EE-crisrmh/VIGIL-Systems/hardware/images/rip_board.jpg

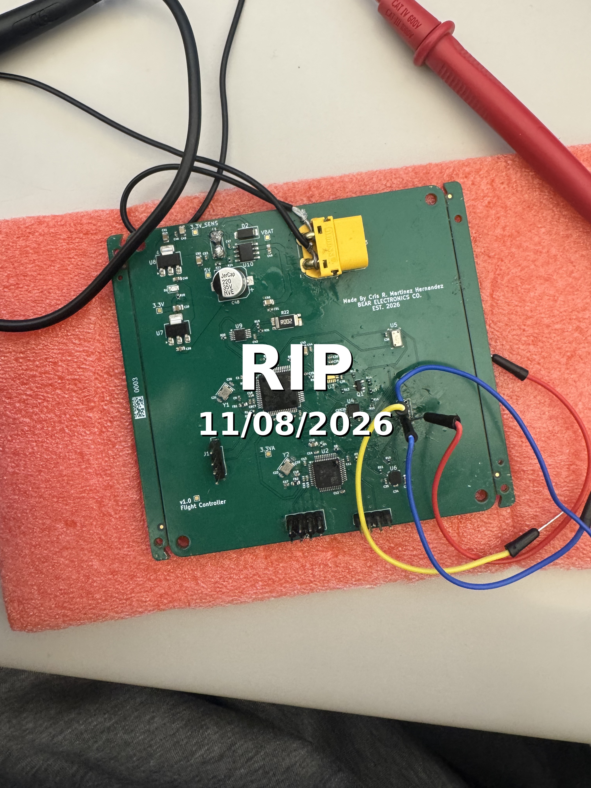
hardware/images/rip_board.jpg
