EE-crisrmh/VIGIL-Systems/software/README.md

# software

companion computer code for the jetson nano: ros2 nodes, mavlink communication with the flight controller, patrol state machine, person detection, photo capture and alarm integration.

status: not started.
