EE-crisrmh/VIGIL-Systems/mechanical/cad/f450_frame_cross_clips_fc_holes.3mf

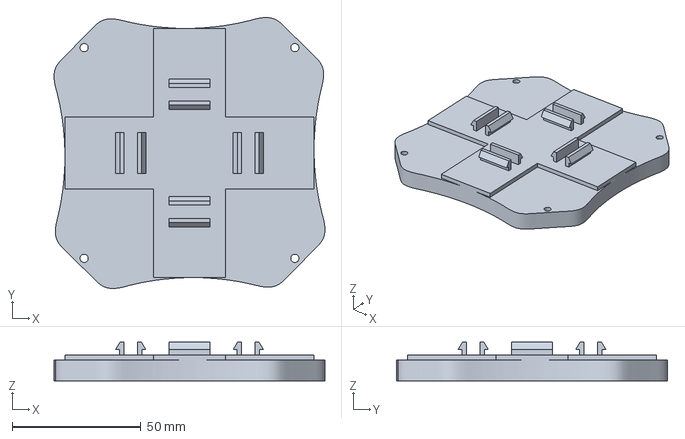
[picture p20: CAD file, 2026-11-03]
mechanical/cad/f450_frame_cross_clips_fc_holes.3mf
105.4 x 105.4 x 15.0 mm
