EE-crisrmh/VIGIL-Systems/mechanical/cad/FlightControllerv1.0.step

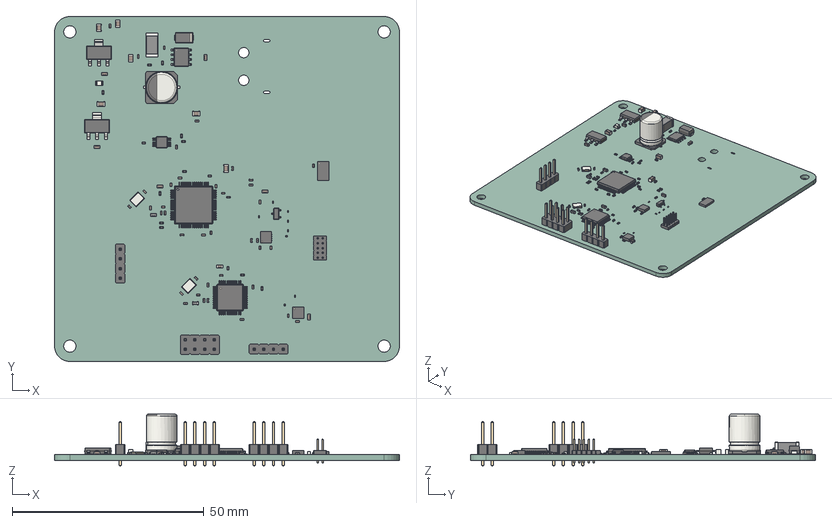
[picture p21: CAD file, 2026-11-03]
mechanical/cad/FlightControllerv1.0.step
90.0 x 90.0 x 13.5 mm
PinHeader_2x05_P1.27mm_Vertical
PinHeader_1x04_P2.54mm_Vertical x 2
R_0201_0603Metric x 8
C_0402_1005Metric x 39
C_0603_1608Metric x 7
PinHeader_2x04_P2.54mm_Vertical
LED_0805_2012Metric
HTSOP-8-1EP_3.9x4.9mm_Pitch1.27mm
L_0603_1608Metric x 2
C_0805_2012Metric x 6
R_0402_1005Metric x 15
LGA-16_3x3mm_P0.5mm x 2
VSSOP-10_3x3mm_P0.5mm
D_SMA
LQFP-48_7x7mm_P0.5mm
Crystal_SMD_3225-4Pin_3.2x2.5mm x 2
SOT-223 x 2
LQFP-64_10x10mm_P0.5mm
SOT-23
L_2512_6332Metric
CP_Elec_8x10.5
LGA-8_3x5mm_P1.25mm
FlightControllerv1.0_PCB
