EE-crisrmh/VIGIL-Systems/(list of files, cad)

Other CAD files:
mechanical/cad/.stl
