EE-crisrmh/VIGIL-Systems/hardware/kicad/FlightControllerv1.0.pdf

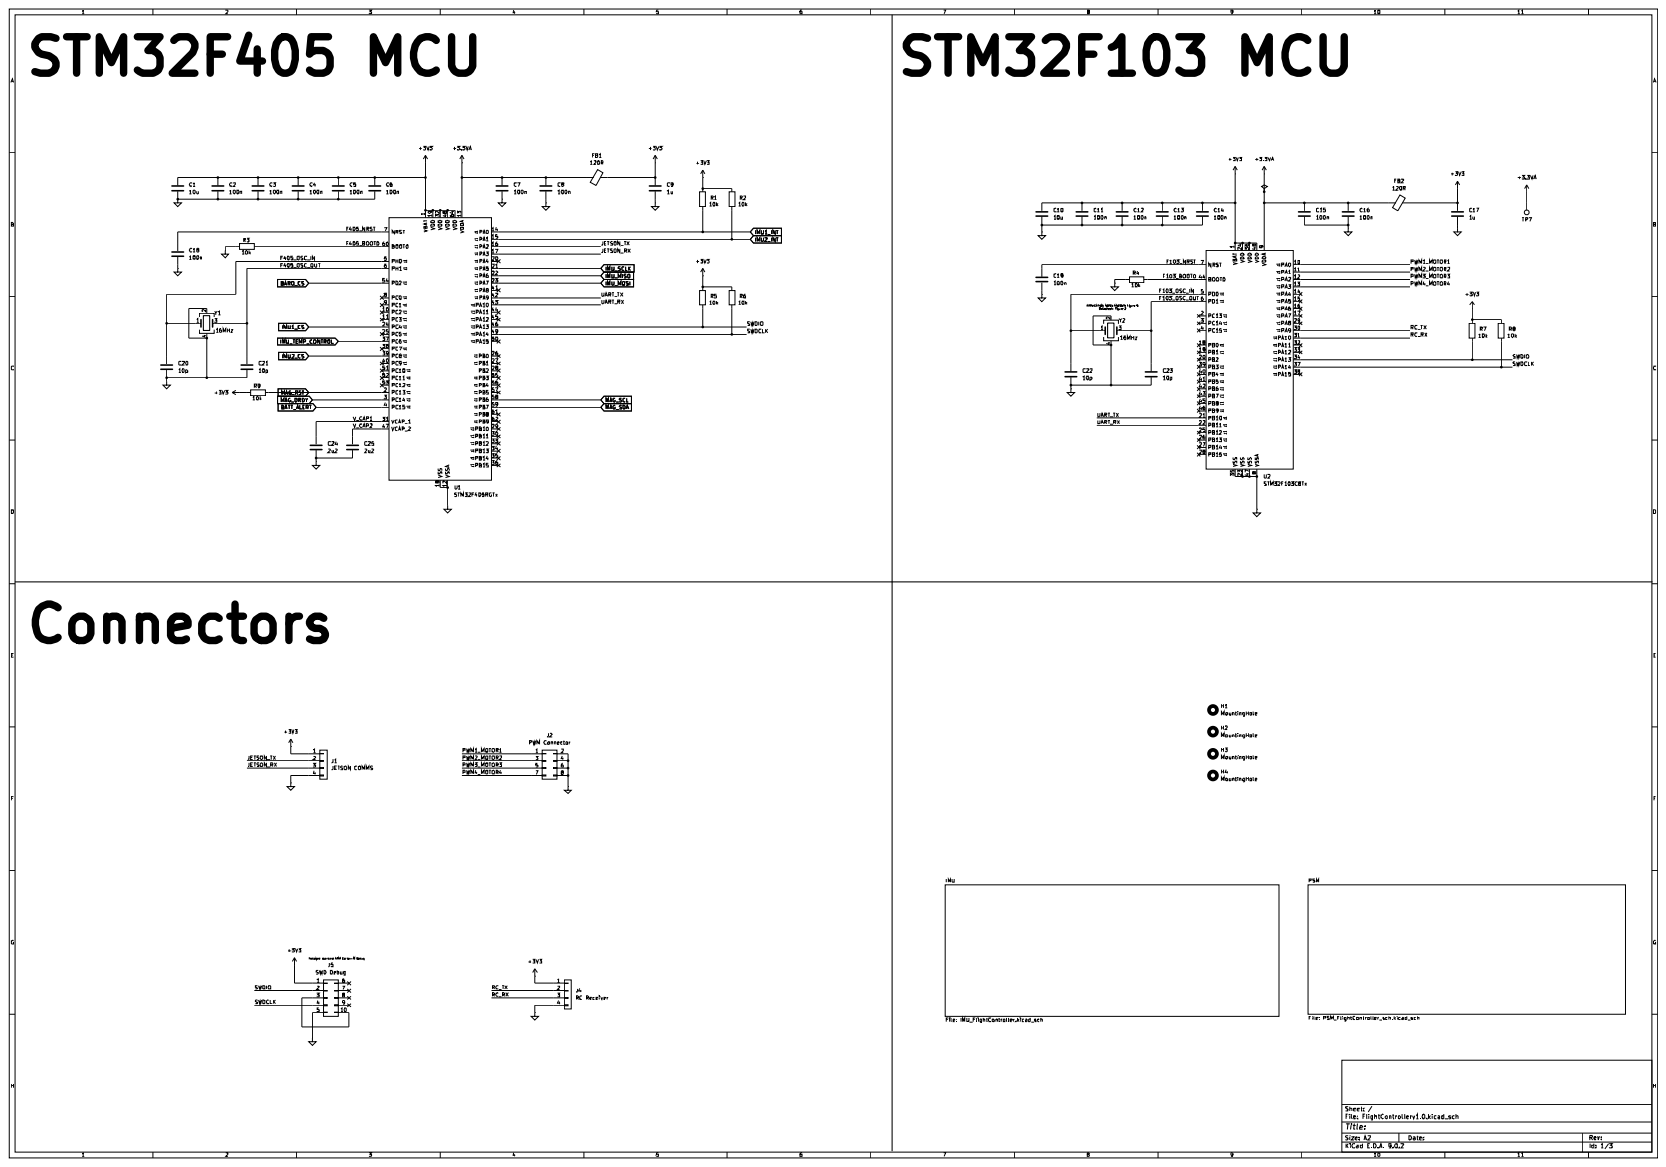
[picture p22: page 1]

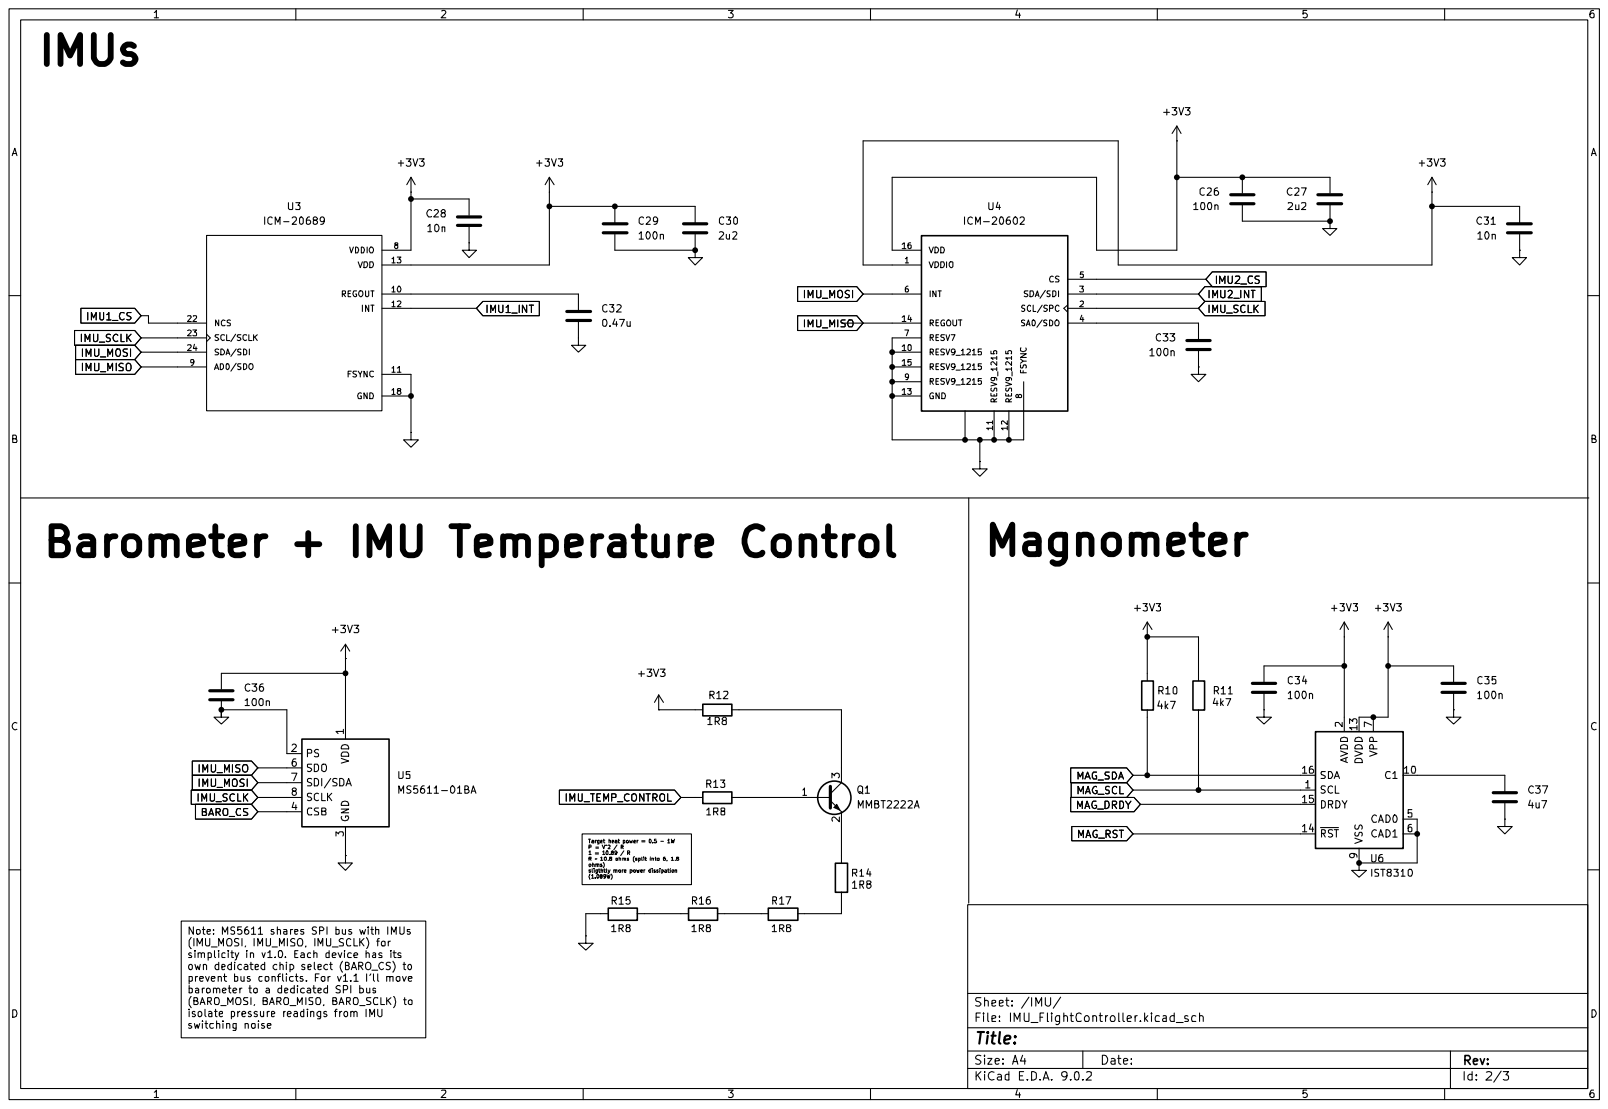
[picture p23: page 2]

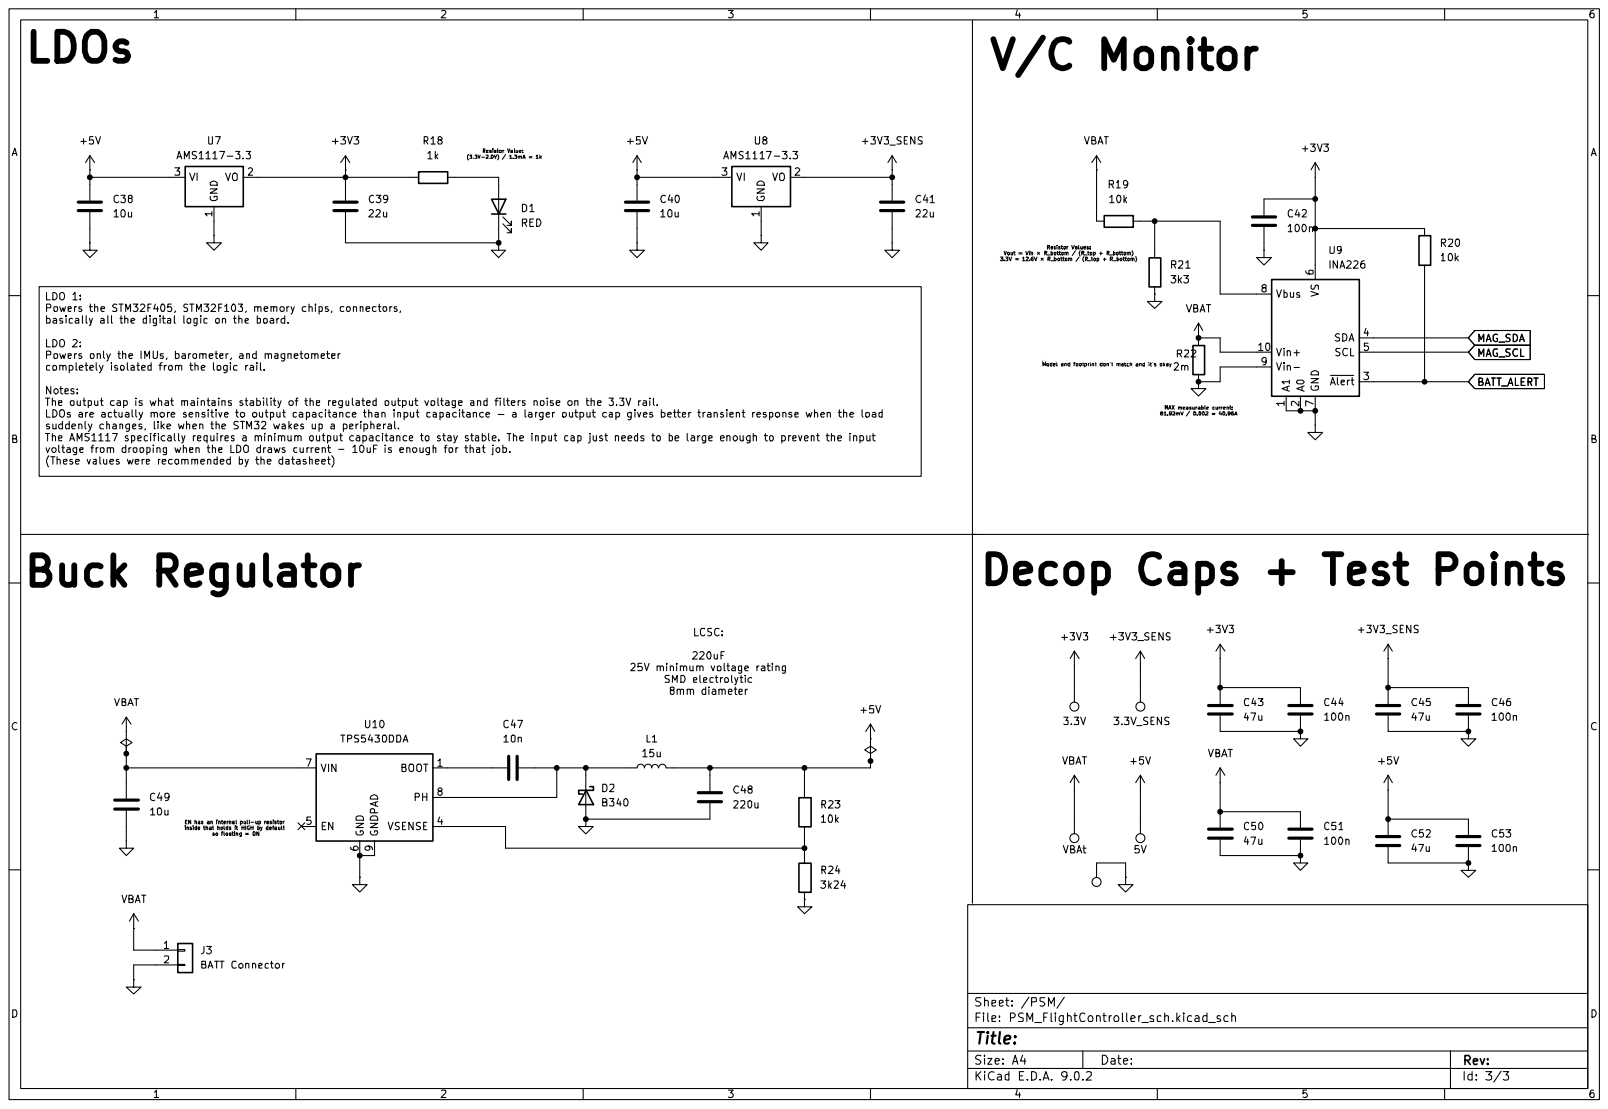
[picture p24: page 3]
