EE-crisrmh/VIGIL-Systems/hardware/assembly/FlightControllerv1.0-B_Cu.pdf

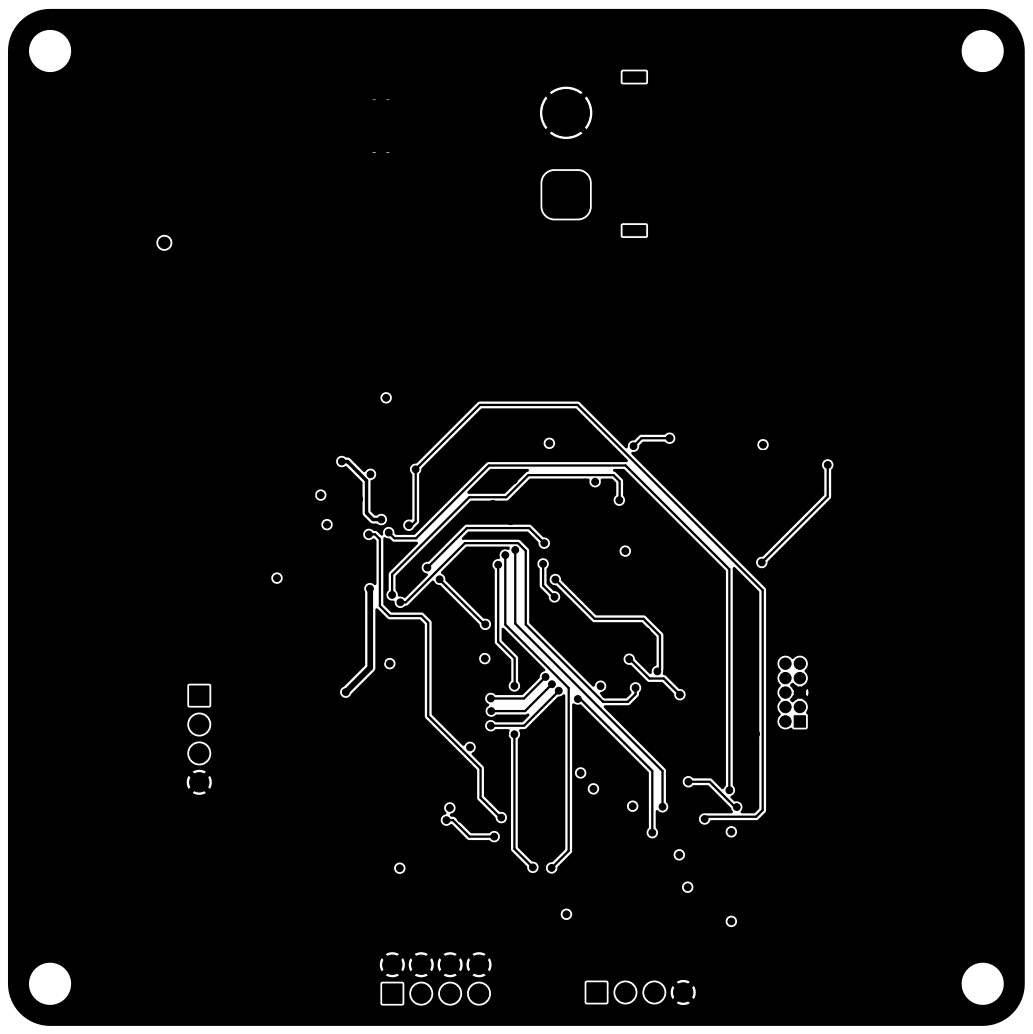
[picture p25: page 1]
