EE-crisrmh/VIGIL-Systems/hardware/assembly/FlightControllerv1.0-B_Mask.pdf

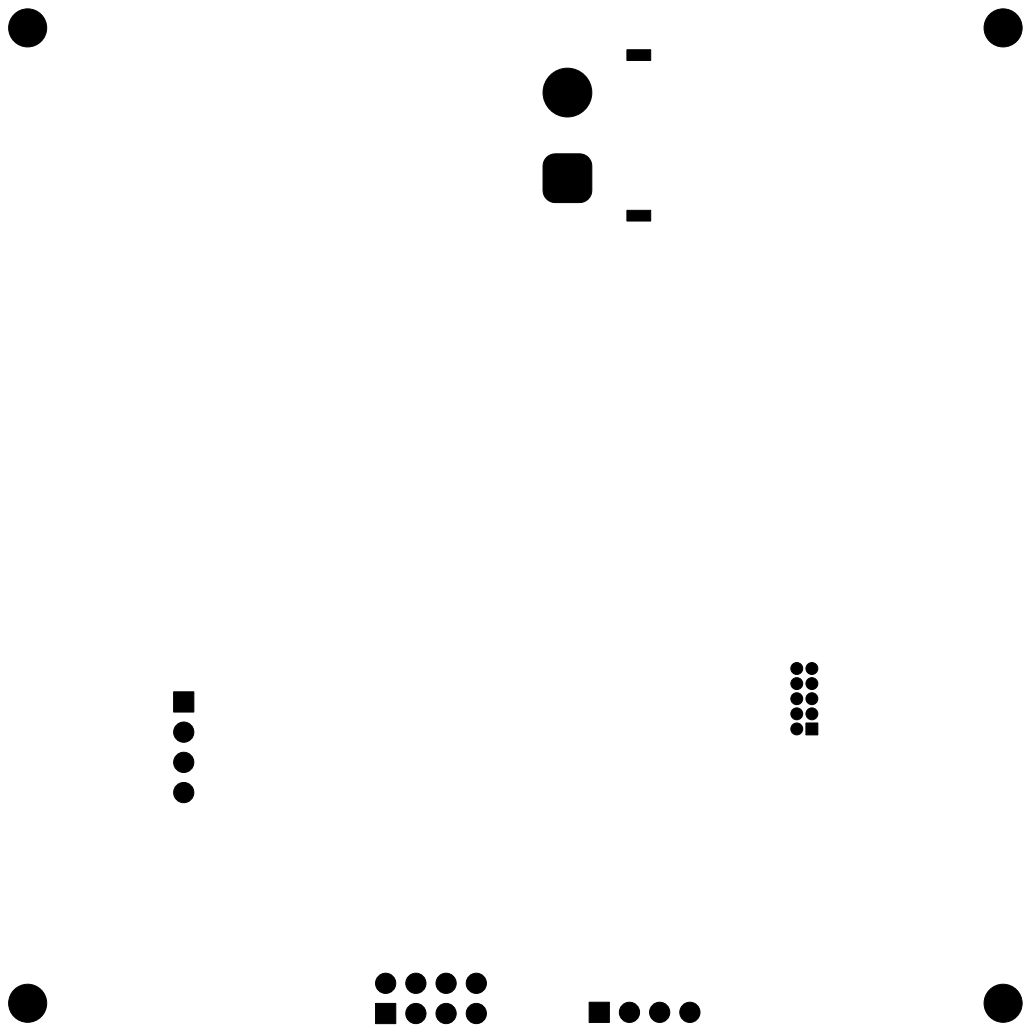
[picture p26: page 1]
