EE-crisrmh/VIGIL-Systems/hardware/assembly/FlightControllerv1.0-Edge_Cuts.pdf

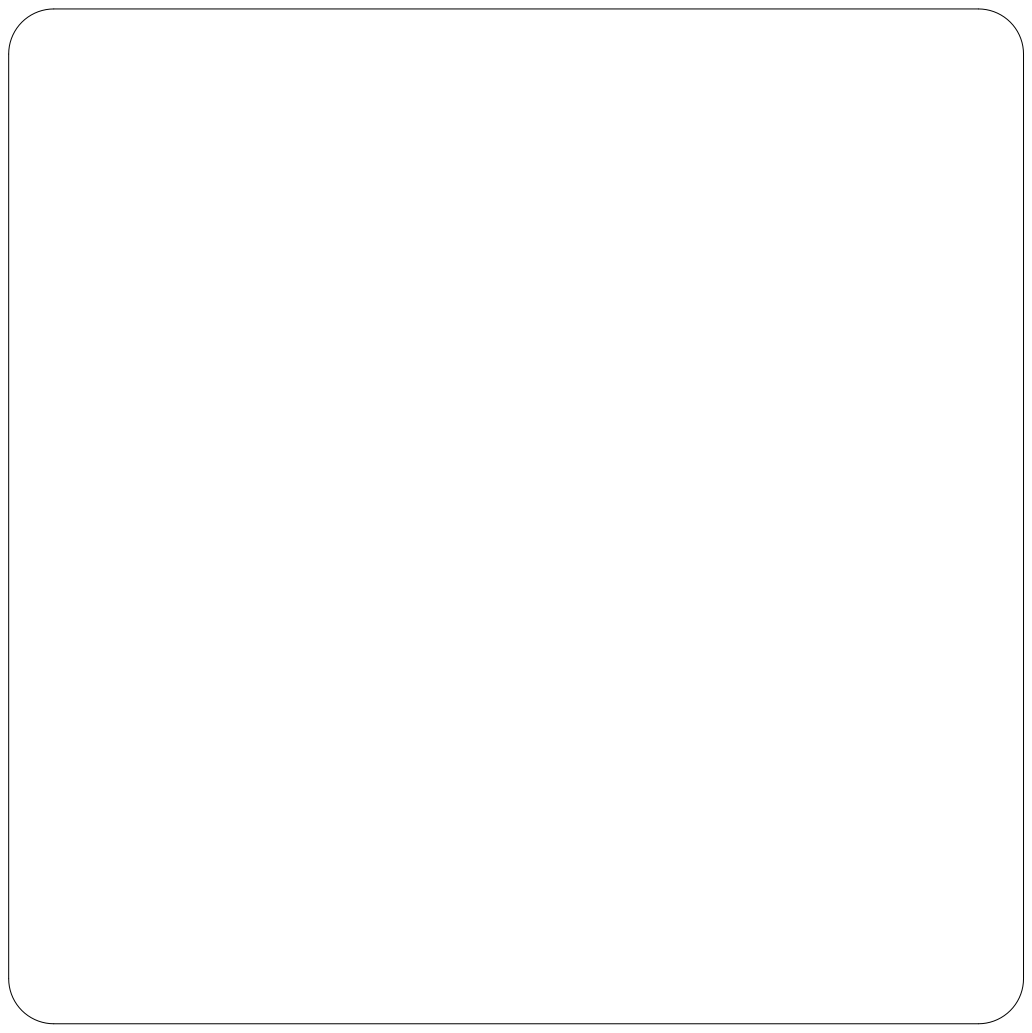
[picture p27: page 1]
