EE-crisrmh/VIGIL-Systems/hardware/assembly/FlightControllerv1.0-F_Cu.pdf

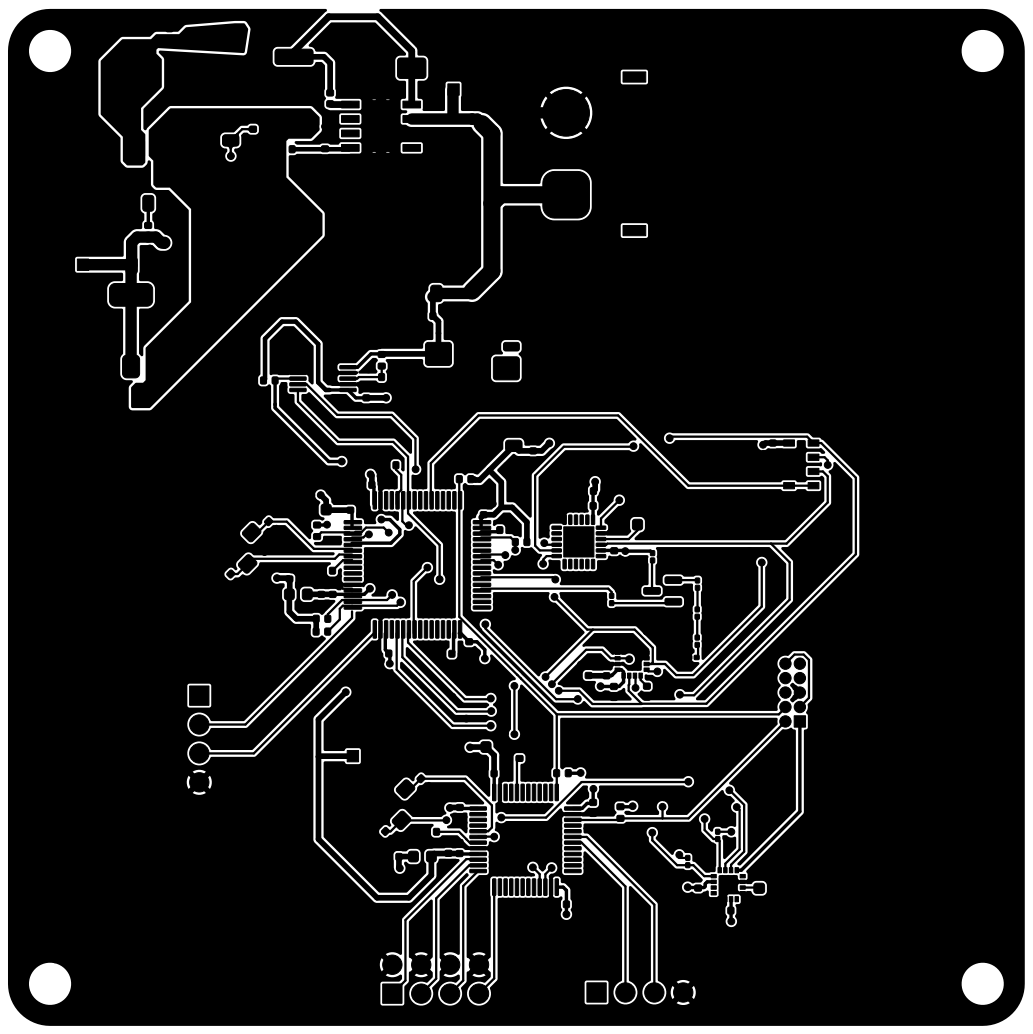
[picture p28: page 1]
