EE-crisrmh/VIGIL-Systems/hardware/assembly/FlightControllerv1.0-F_Mask.pdf

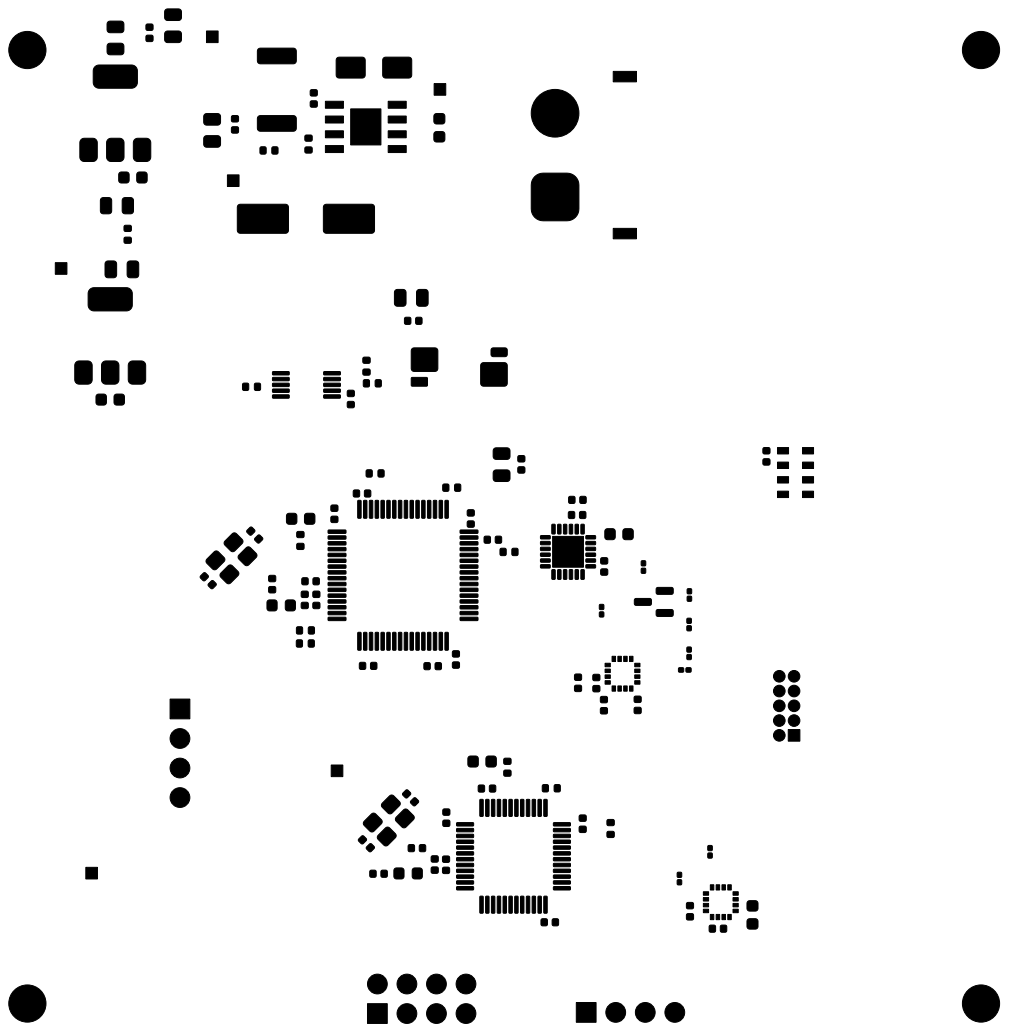
[picture p29: page 1]
