EE-crisrmh/VIGIL-Systems/hardware/assembly/FlightControllerv1.0-F_Paste.pdf

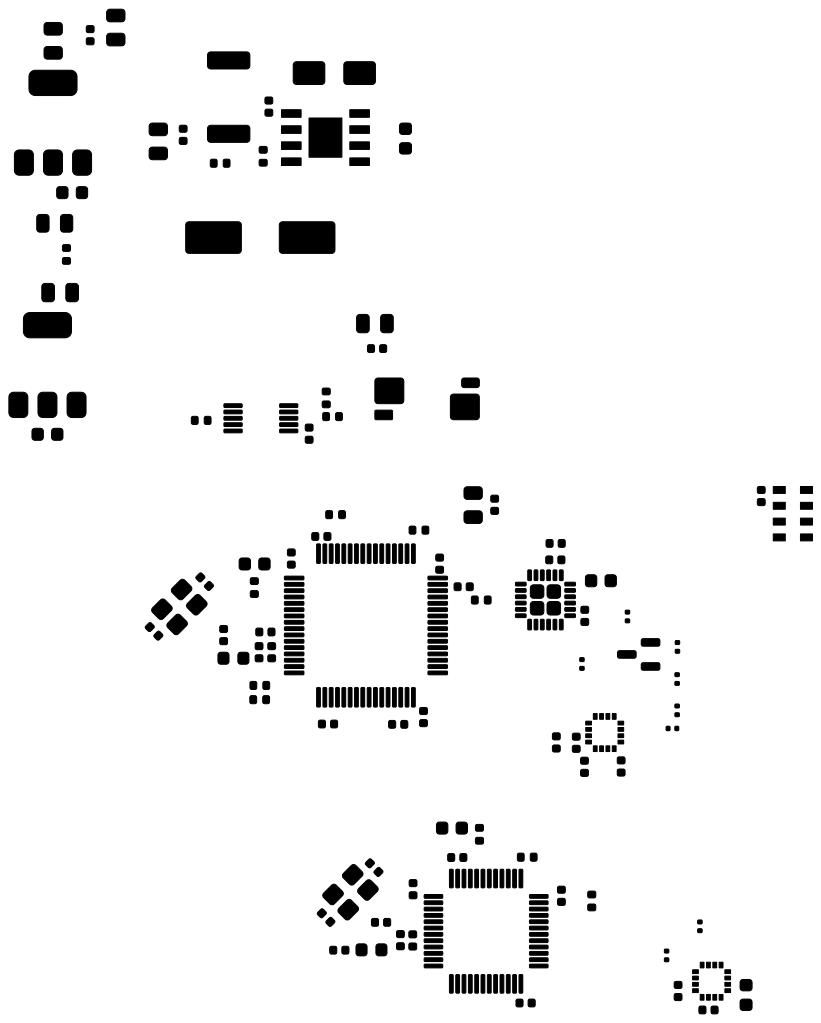
[picture p30: page 1]
