EE-crisrmh/VIGIL-Systems/hardware/assembly/FlightControllerv1.0-F_Silkscreen.pdf

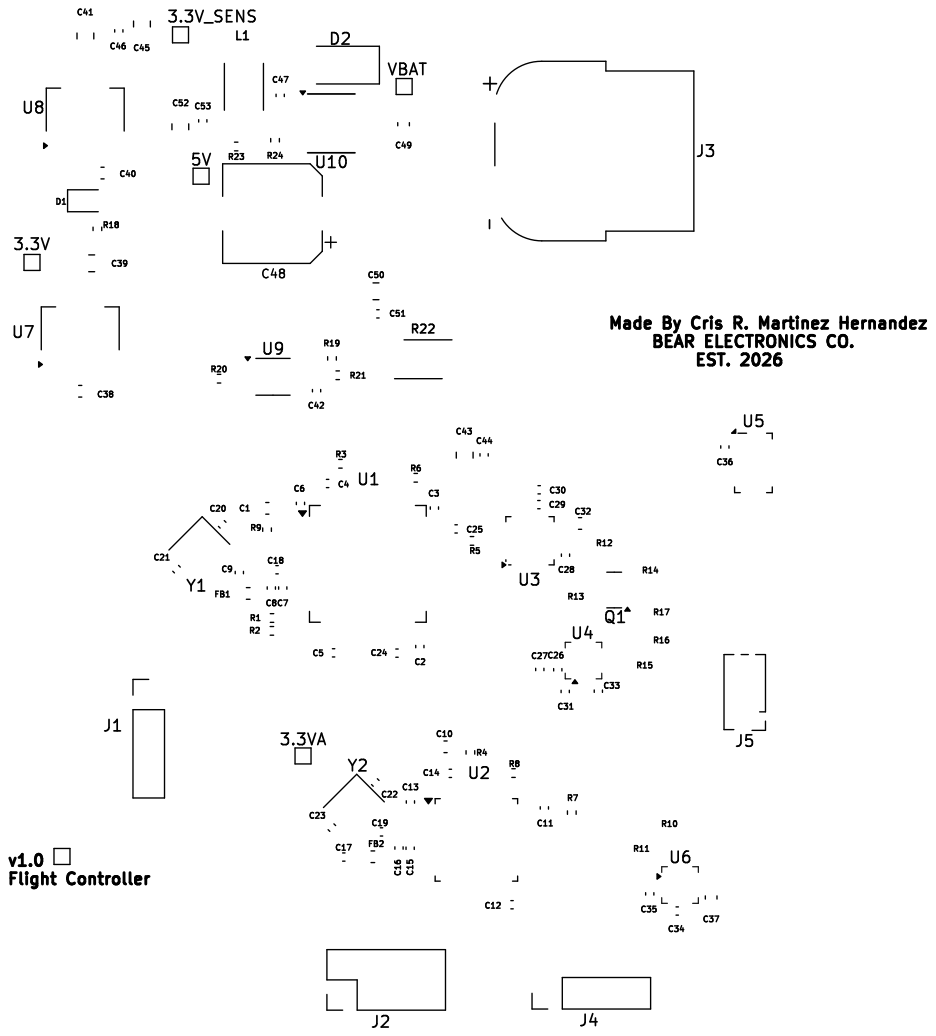
[picture p31: page 1]
