EE-crisrmh/VIGIL-Systems/hardware/kicad/FlightControllerv1.0.kicad_pcb

## KiCad design hardware/kicad/FlightControllerv1.0.kicad_pcb (2026-11-03)

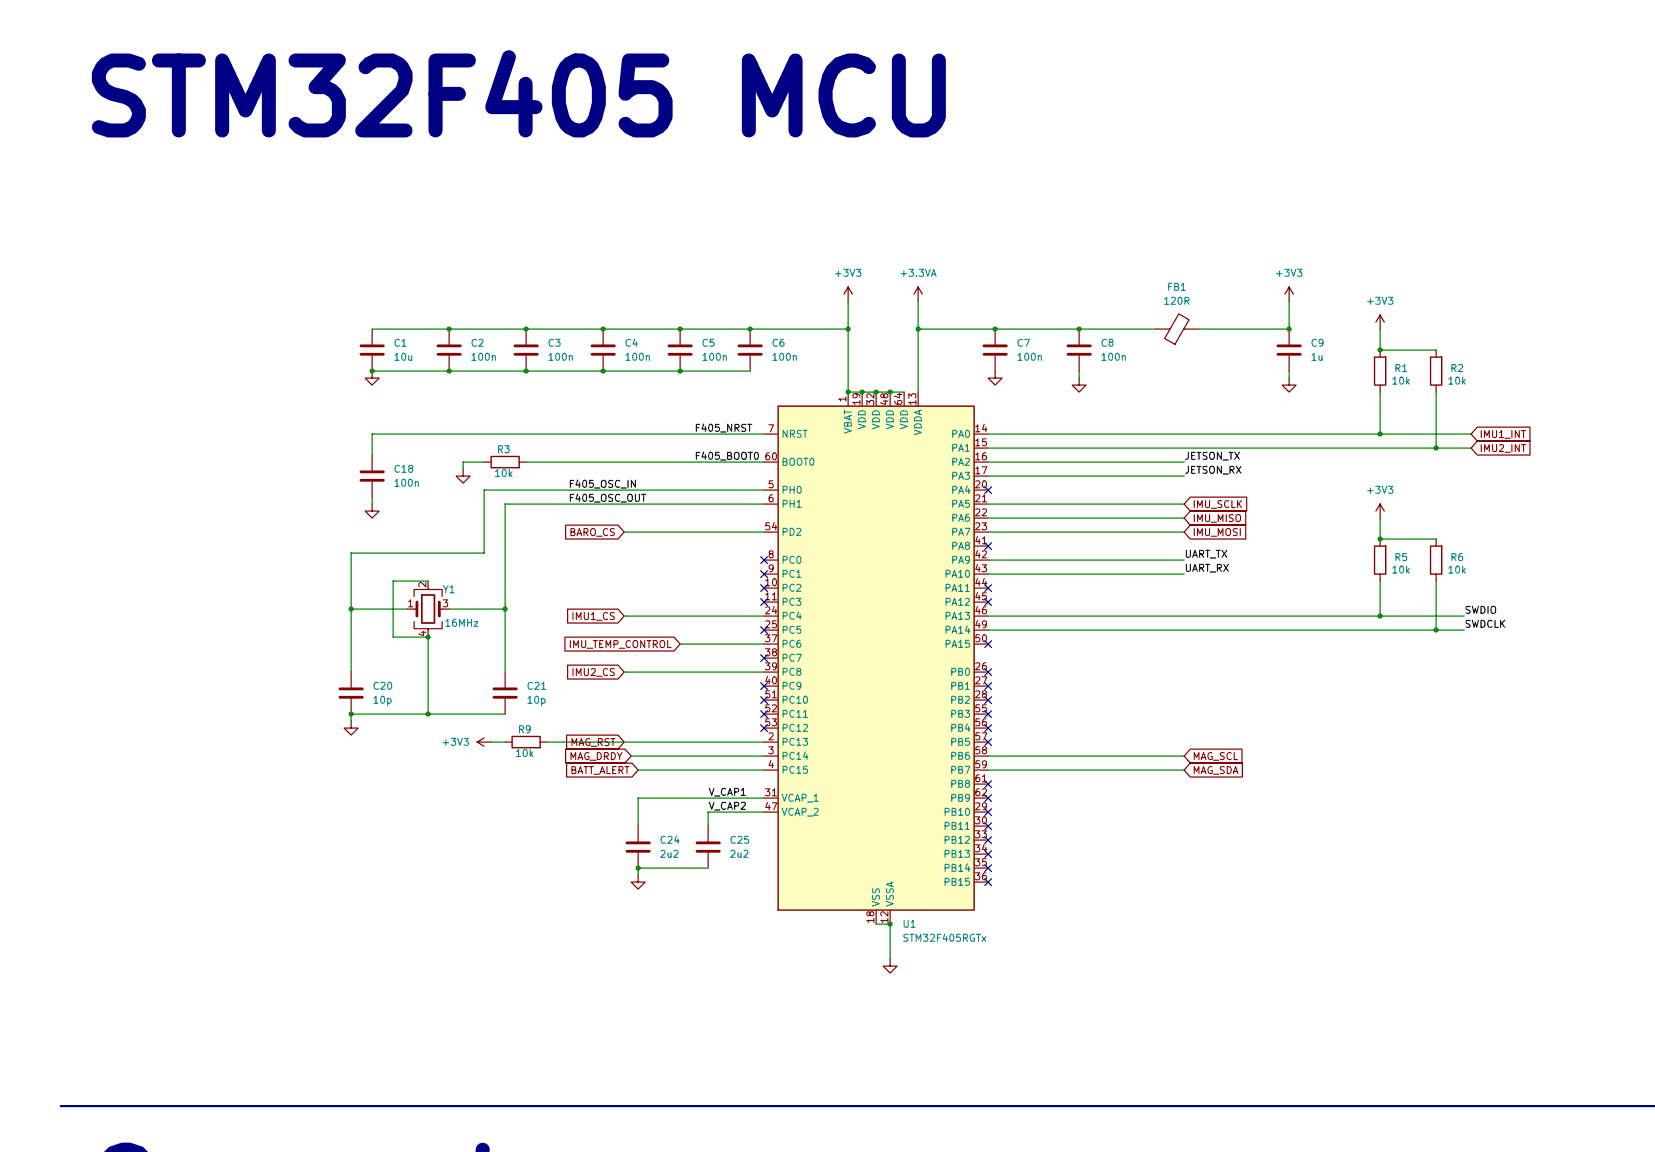
[picture p32: schematic FlightControllerv1.0.kicad_sch, part in row 1, column 1]

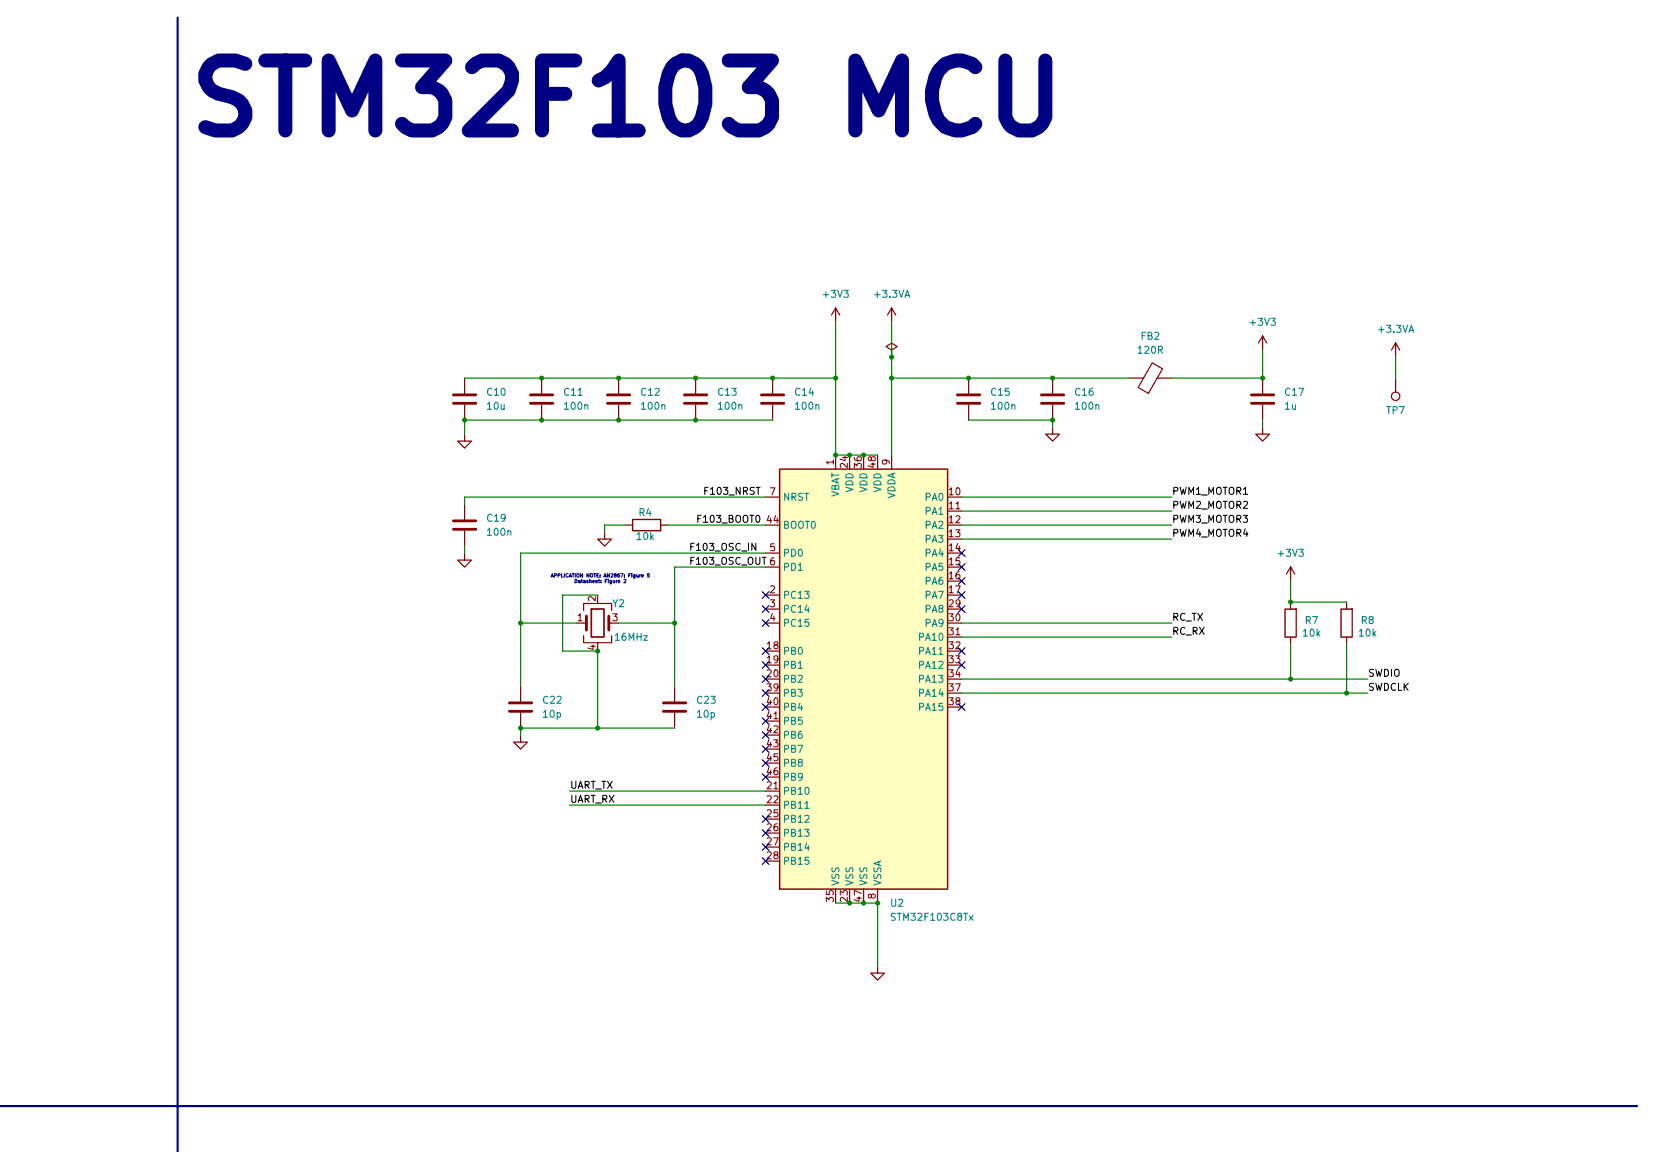
[picture p33: schematic FlightControllerv1.0.kicad_sch, part in row 1, column 2]

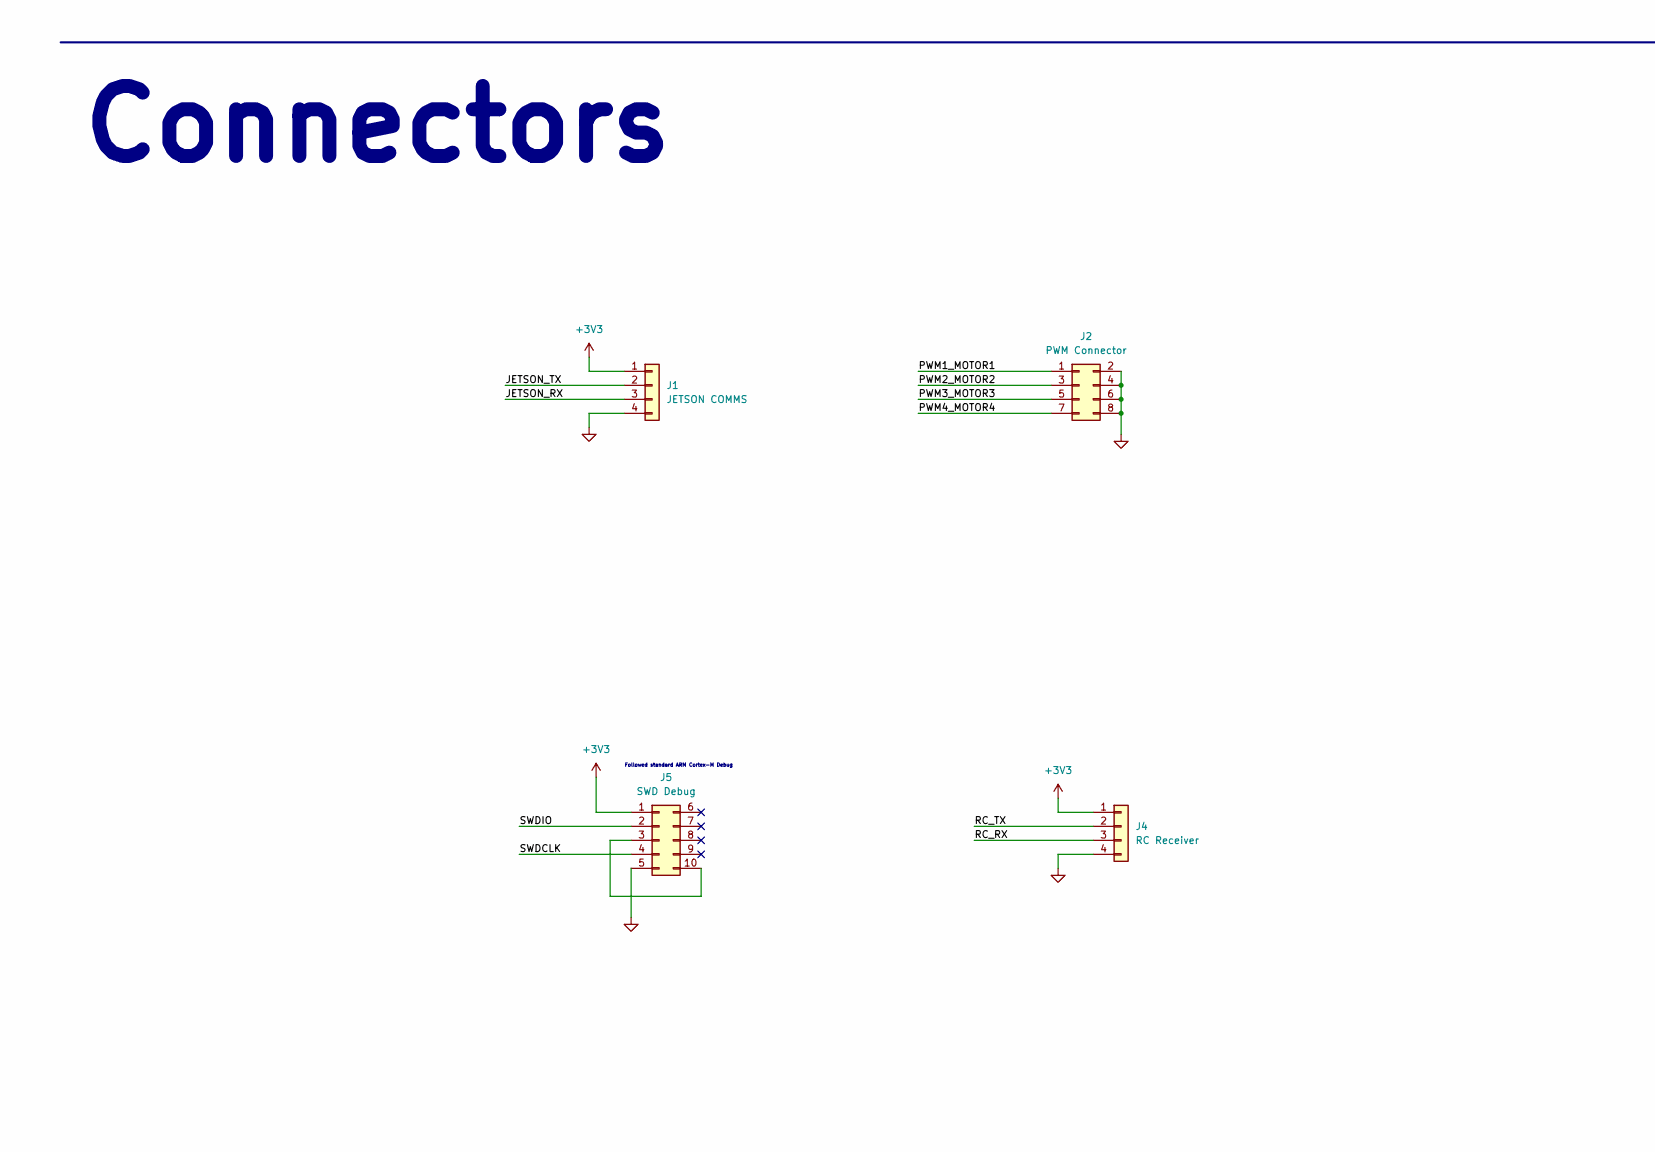
[picture p34: schematic FlightControllerv1.0.kicad_sch, part in row 2, column 1]

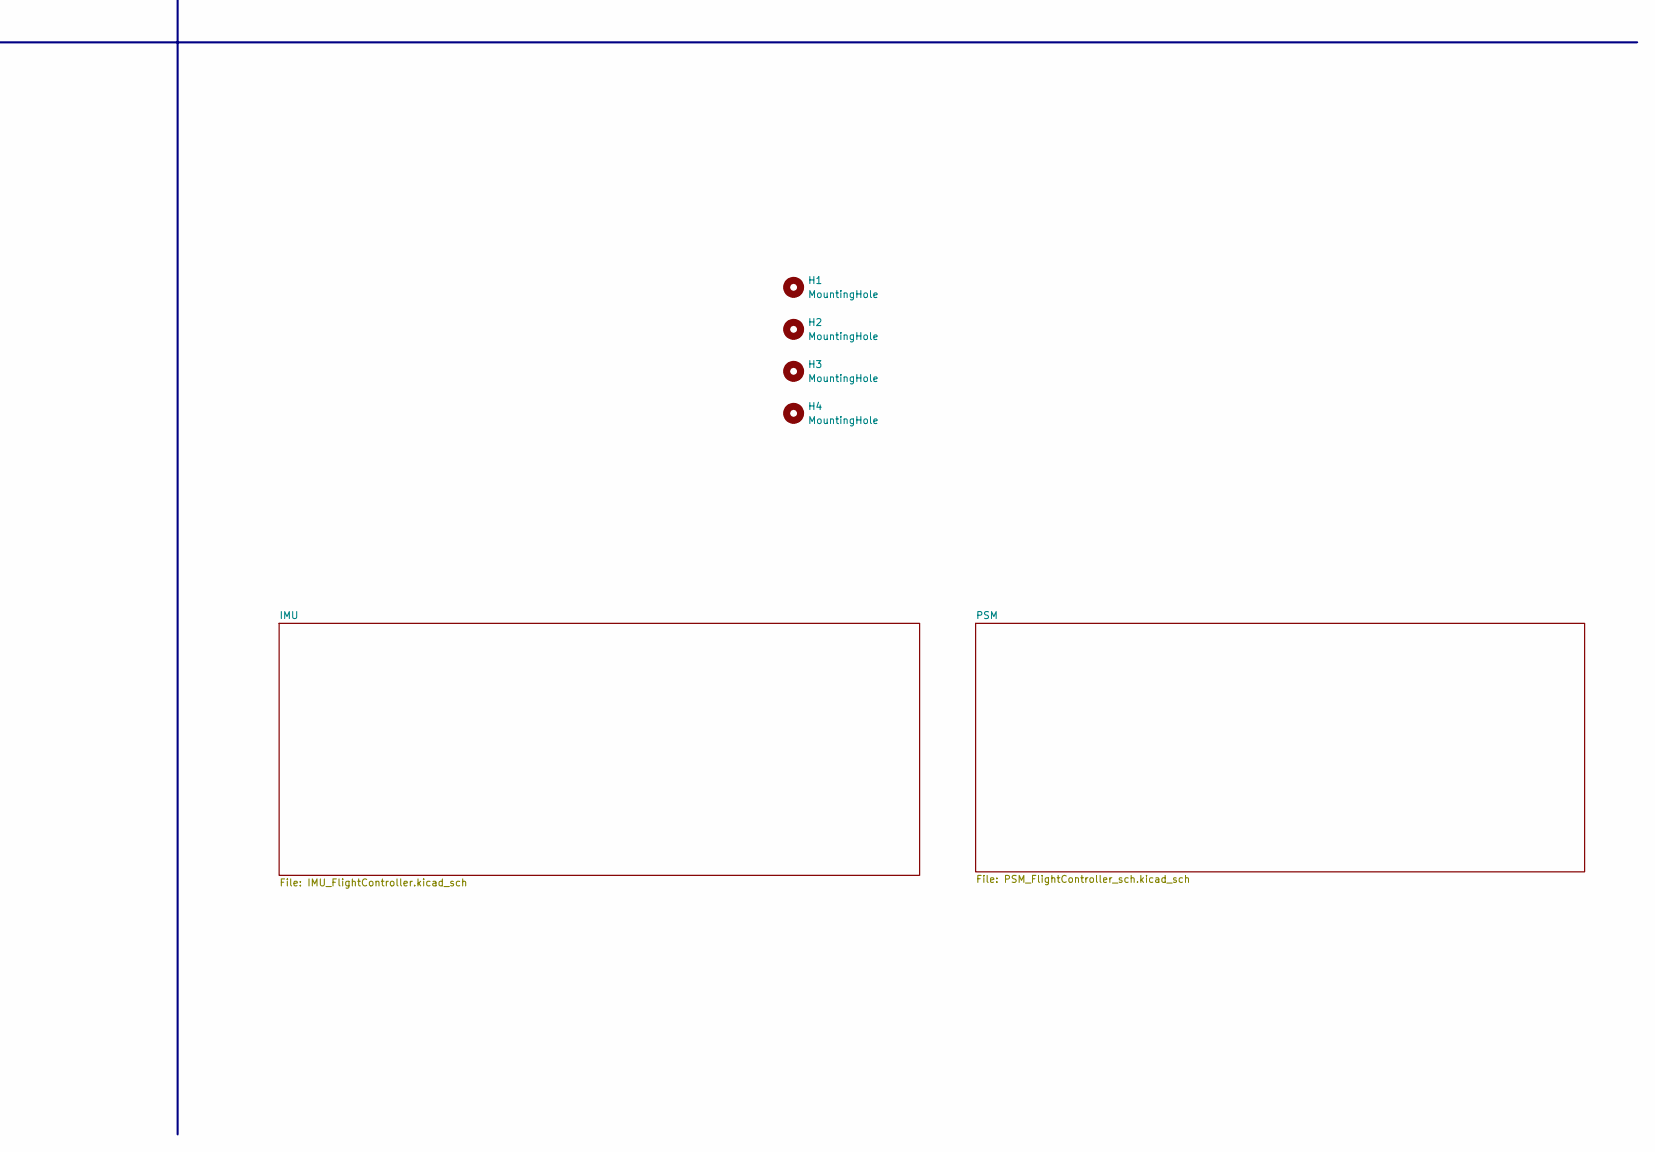
[picture p35: schematic FlightControllerv1.0.kicad_sch, part in row 2, column 2]

Parts:
C1, C10: 10u; C_0603_1608Metric
C2, C3, C4, C5, C6, C7, C8, C11, C12, C13, C14, C15, C16, C18, C19: 100n; C_0402_1005Metric
C9, C17: 1u; C_0402_1005Metric
C20, C21, C22, C23: 10p; C_0402_1005Metric
C24, C25: 2u2; C_0402_1005Metric
FB1, FB2: 120R; L_0603_1608Metric
H1, H2, H3, H4: MountingHole; MountingHole_3.2mm_M3
J1: JETSON COMMS; PinHeader_1x04_P2.54mm_Vertical
J2: PWM Connector; PinHeader_2x04_P2.54mm_Vertical
J4: RC Receiver; PinHeader_1x04_P2.54mm_Vertical
J5: SWD Debug; PinHeader_2x05_P1.27mm_Vertical
R1, R2, R3, R4, R5, R6, R7, R8, R9: 10k; R_0402_1005Metric
TP7: TestPoint; TestPoint_Pad_1.0x1.0mm
U1: STM32F405RGTx; LQFP-64_10x10mm_P0.5mm
U2: STM32F103C8Tx; LQFP-48_7x7mm_P0.5mm
Y1, Y2: 16MHz; Crystal_SMD_3225-4Pin_3.2x2.5mm

Connections:
+3.3VA: C7.1, C8.1, C15.1, C16.1, FB1.1, FB2.1, TP7.1, U1.13 (VDDA), U2.9 (VDDA); also elsewhere on the board
+3V3: C1.1, C2.1, C3.1, C4.1, C5.1, C6.1, C9.1, C10.1, C11.1, C12.1, C13.1, C14.1, C17.1, FB1.2, FB2.2, J1.1, J4.1, J5.1, R1.2, R2.2, R5.2, R6.2, R7.2, R8.2, R9.1, U1.1 (VBAT), U1.19 (VDD), U1.32 (VDD), U1.48 (VDD), U1.64 (VDD), U2.1 (VBAT), U2.24 (VDD), U2.36 (VDD), U2.48 (VDD); also elsewhere on the board
/F103_BOOT0: R4.2, U2.44 (BOOT0)
/F103_NRST: C19.1, U2.7 (NRST)
/F103_OSC_IN: C22.1, U2.5 (PD0), Y2.1
/F103_OSC_OUT: C23.1, U2.6 (PD1), Y2.3
/F405_BOOT0: R3.2, U1.60 (BOOT0)
/F405_NRST: C18.1, U1.7 (NRST)
/F405_OSC_IN: C20.1, U1.5 (PH0), Y1.1
/F405_OSC_OUT: C21.1, U1.6 (PH1), Y1.3
/JETSON_RX: J1.3, U1.17 (PA3)
/JETSON_TX: J1.2, U1.16 (PA2)
/PWM1_MOTOR1: J2.1, U2.10 (PA0)
/PWM2_MOTOR2: J2.3, U2.11 (PA1)
/PWM3_MOTOR3: J2.5, U2.12 (PA2)
/PWM4_MOTOR4: J2.7, U2.13 (PA3)
/RC_RX: J4.3, U2.31 (PA10)
/RC_TX: J4.2, U2.30 (PA9)
/SWDCLK: J5.4, R6.1, R8.1, U1.49 (PA14), U2.37 (PA14)
/SWDIO: J5.2, R5.1, R7.1, U1.46 (PA13), U2.34 (PA13)
/UART_RX: U1.43 (PA10), U2.22 (PB11)
/UART_TX: U1.42 (PA9), U2.21 (PB10)
/V_CAP1: C24.1, U1.31 (VCAP_1)
/V_CAP2: C25.1, U1.47 (VCAP_2)
BARO_CS: U1.54 (PD2); also elsewhere on the board
BATT_ALERT: U1.4 (PC15); also elsewhere on the board
GND: C1.2, C2.2, C3.2, C4.2, C5.2, C6.2, C7.2, C8.2, C9.2, C10.2, C11.2, C12.2, C13.2, C14.2, C15.2, C16.2, C17.2, C18.2, C19.2, C20.2, C21.2, C22.2, C23.2, C24.2, C25.2, J1.4, J2.2, J2.4, J2.6, J2.8, J4.4, J5.5, R3.1, R4.1, U1.12 (VSSA), U1.18 (VSS), U1.63 (VSS), U2.8 (VSSA), U2.23 (VSS), U2.35 (VSS), U2.47 (VSS), Y1.2, Y1.4, Y2.2, Y2.4; also elsewhere on the board
IMU1_CS: U1.24 (PC4); also elsewhere on the board
IMU1_INT: R1.1, U1.14 (PA0); also elsewhere on the board
IMU2_CS: U1.39 (PC8); also elsewhere on the board
IMU2_INT: R2.1, U1.15 (PA1); also elsewhere on the board
IMU_MISO: U1.22 (PA6); also elsewhere on the board
IMU_MOSI: U1.23 (PA7); also elsewhere on the board
IMU_SCLK: U1.21 (PA5); also elsewhere on the board
IMU_TEMP_CONTROL: U1.37 (PC6); also elsewhere on the board
MAG_DRDY: U1.3 (PC14); also elsewhere on the board
MAG_RST: R9.2, U1.2 (PC13); also elsewhere on the board
MAG_SCL: U1.58 (PB6); also elsewhere on the board
MAG_SDA: U1.59 (PB7); also elsewhere on the board
unnamed: J5.3, J5.10

Notes on the sheet:
APPLICATION NOTE: AN2867: Figure 5 Datasheet: Figure 2
STM32F103 MCU
STM32F405 MCU
Followed standard ARM Cortex-M Debug
Connectors

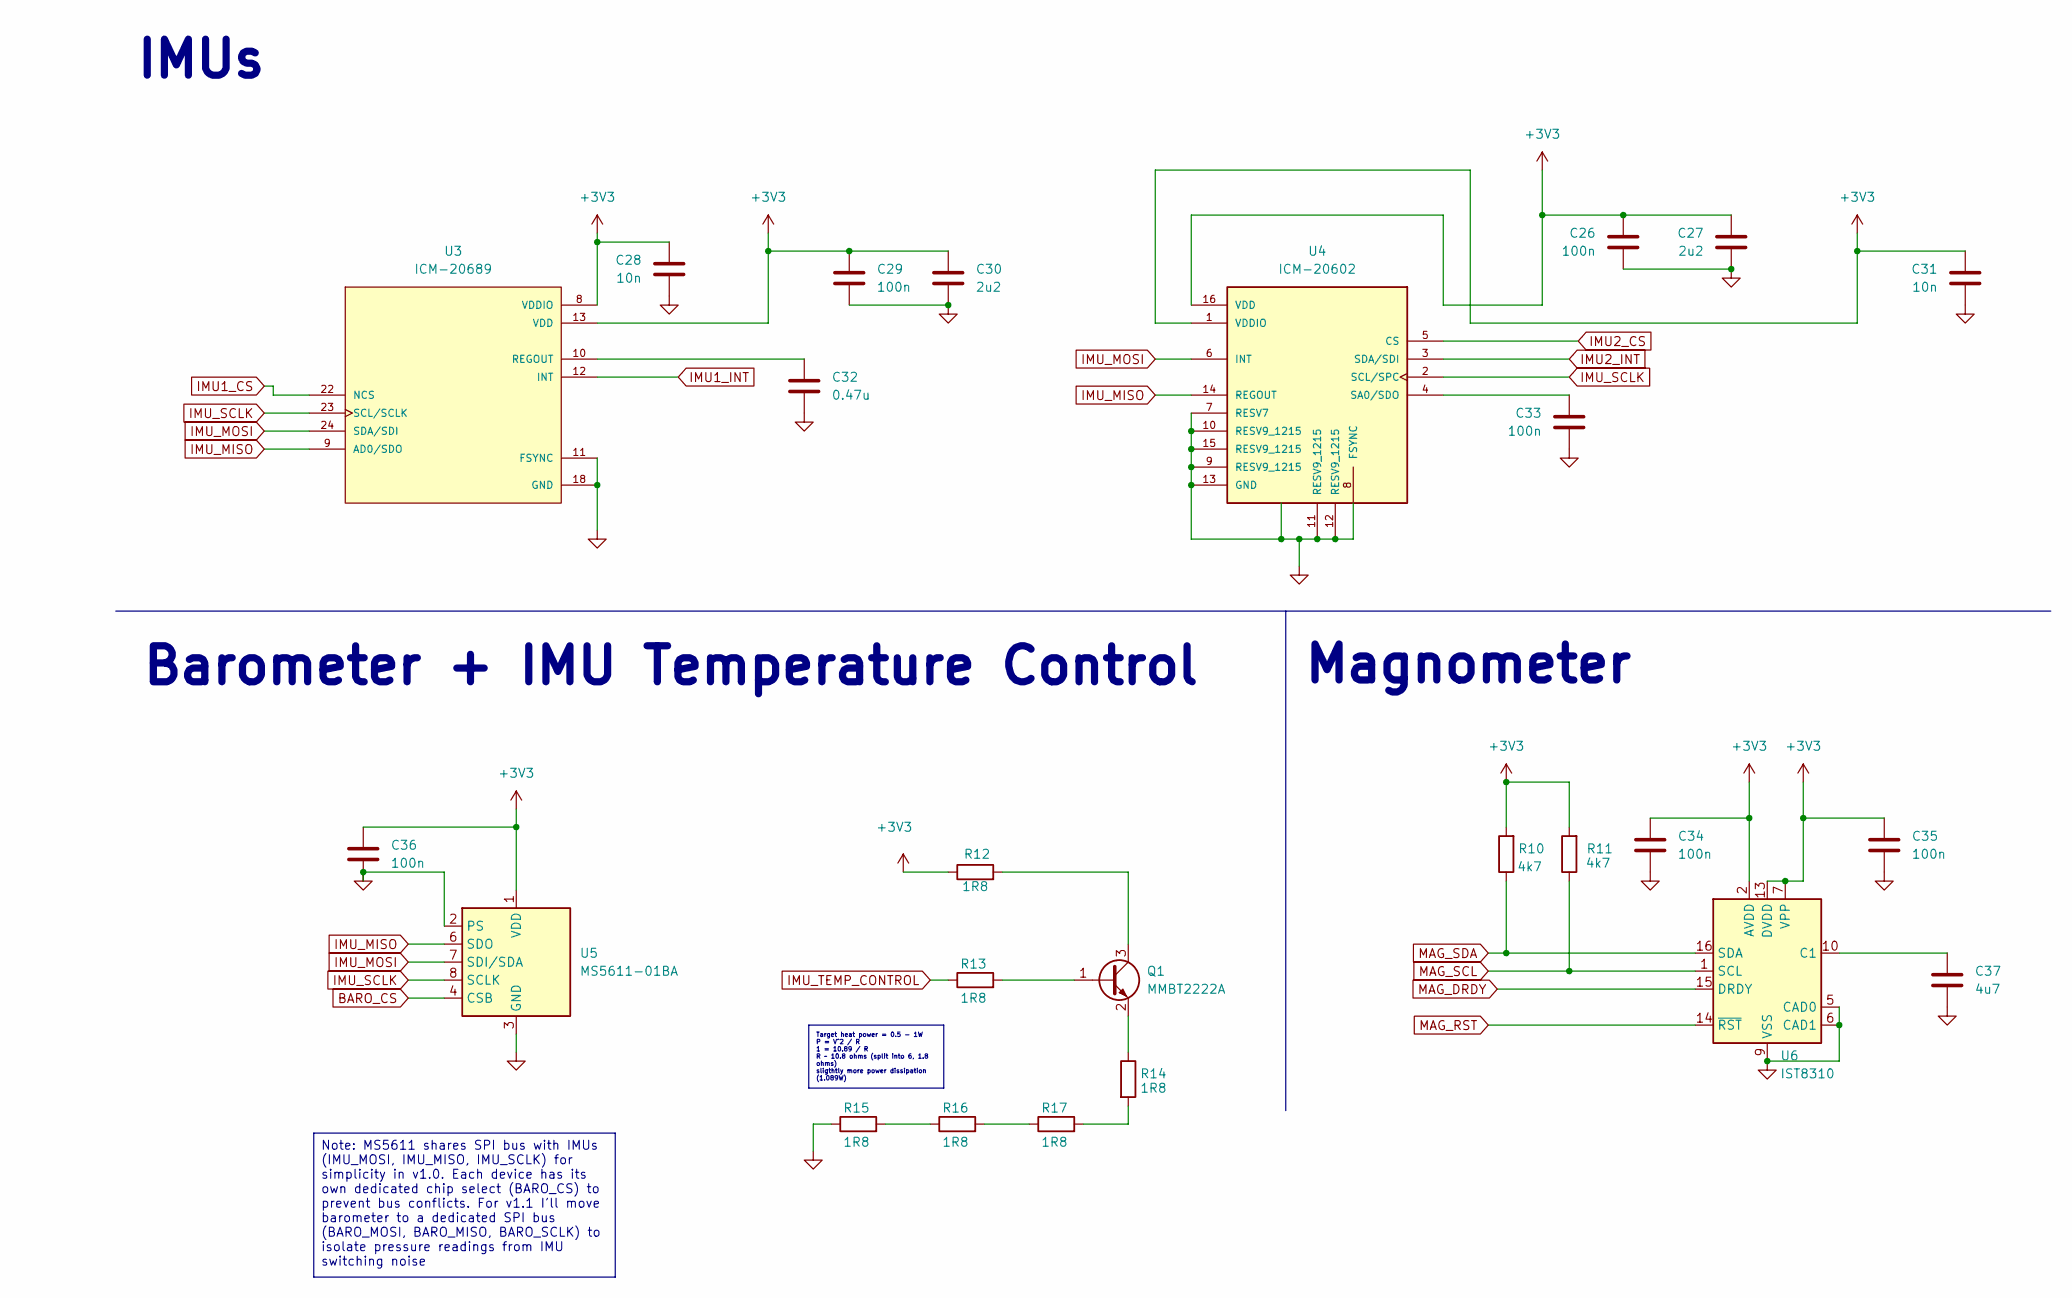
[picture p36: schematic IMU_FlightController.kicad_sch]

Parts:
C26, C29, C33, C34, C35, C36: 100n; C_0402_1005Metric
C27, C30: 2u2; C_0402_1005Metric
C28, C31: 10n; C_0402_1005Metric
C32: 0.47u; C_0603_1608Metric
C37: 4u7; C_0603_1608Metric
Q1: MMBT2222A; SOT-23
R10, R11: 4k7; R_0201_0603Metric
R12, R13, R14, R15, R16, R17: 1R8; R_0201_0603Metric
U3: ICM-20689; QFN-24-1EP_4x4mm_P0.5mm_EP2.65x2.65mm
U4: ICM-20602; LGA-16_3x3mm_P0.5mm
U5: MS5611-01BA; LGA-8_3x5mm_P1.25mm
U6: IST8310; LGA-16_3x3mm_P0.5mm

Connections:
+3V3: C26.1, C27.1, C28.1, C29.1, C30.1, C31.1, C34.1, C35.1, C36.1, R10.2, R11.2, R12.1, U3.8 (VDDIO), U3.13 (VDD), U4.1 (VDDIO), U4.16 (VDD), U5.1 (VDD), U6.2 (AVDD), U6.7 (VPP), U6.13 (DVDD); also elsewhere on the board
BARO_CS: U5.4 (CSB), U5.5 (CSB); also elsewhere on the board
GND: C26.2, C27.2, C28.2, C29.2, C30.2, C31.2, C32.2, C33.2, C34.2, C35.2, C36.2, C37.2, R15.1, U3.11 (FSYNC), U3.18 (GND), U4.7 (RESV7), U4.8 (FSYNC), U4.9 (RESV9_1215), U4.10 (RESV9_1215), U4.11 (RESV9_1215), U4.12 (RESV9_1215), U4.13 (GND), U4.15 (RESV9_1215), U5.2 (PS), U5.3 (GND), U6.5 (CAD0), U6.6 (CAD1), U6.9 (VSS), U6.11 (VSS); also elsewhere on the board
IMU1_CS: U3.22 (NCS); also elsewhere on the board
IMU1_INT: U3.12 (INT); also elsewhere on the board
IMU2_CS: U4.5 (CS); also elsewhere on the board
IMU2_INT: U4.3 (SDA/SDI); also elsewhere on the board
IMU_MISO: U3.9 (AD0/SDO), U4.14 (REGOUT), U5.6 (SDO); also elsewhere on the board
IMU_MOSI: U3.24 (SDA/SDI), U4.6 (INT), U5.7 (SDI/SDA); also elsewhere on the board
IMU_SCLK: U3.23 (SCL/SCLK), U4.2 (SCL/SPC), U5.8 (SCLK); also elsewhere on the board
IMU_TEMP_CONTROL: R13.1; also elsewhere on the board
MAG_DRDY: U6.15 (DRDY); also elsewhere on the board
MAG_RST: U6.14 (~RST); also elsewhere on the board
MAG_SCL: R11.1, U6.1 (SCL); also elsewhere on the board
MAG_SDA: R10.1, U6.16 (SDA); also elsewhere on the board
unnamed: Q1.1 (B), R13.2
unnamed: Q1.3 (C), R12.2
unnamed: Q1.2 (E), R14.1
unnamed: R14.2, R17.2
unnamed: R15.2, R16.1
unnamed: R16.2, R17.1
unnamed: C32.1, U3.10 (REGOUT)
unnamed: C33.1, U4.4 (SA0/SDO)
unnamed: C37.1, U6.10 (C1)

Notes on the sheet:
Barometer + IMU Temperature Control
Magnometer
IMUs
Note: MS5611 shares SPI bus with IMUs (IMU_MOSI, IMU_MISO, IMU_SCLK) for simplicity in v1.0. Each device has its own dedicated chip select (BARO_CS) to prevent bus conflicts. For v1.1 I'll move barometer to a dedicated SPI bus (BARO_MOSI, BARO_MISO, BARO_SCLK) to isolate pressure readings from IMU 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
Target heat power = 0.5 - 1W P = V^2 / R 1 = 10.89 / R R ~ 10.8 ohms (split into 6, 1.8 ohms) sligthtly more power dissipation (1.089W)

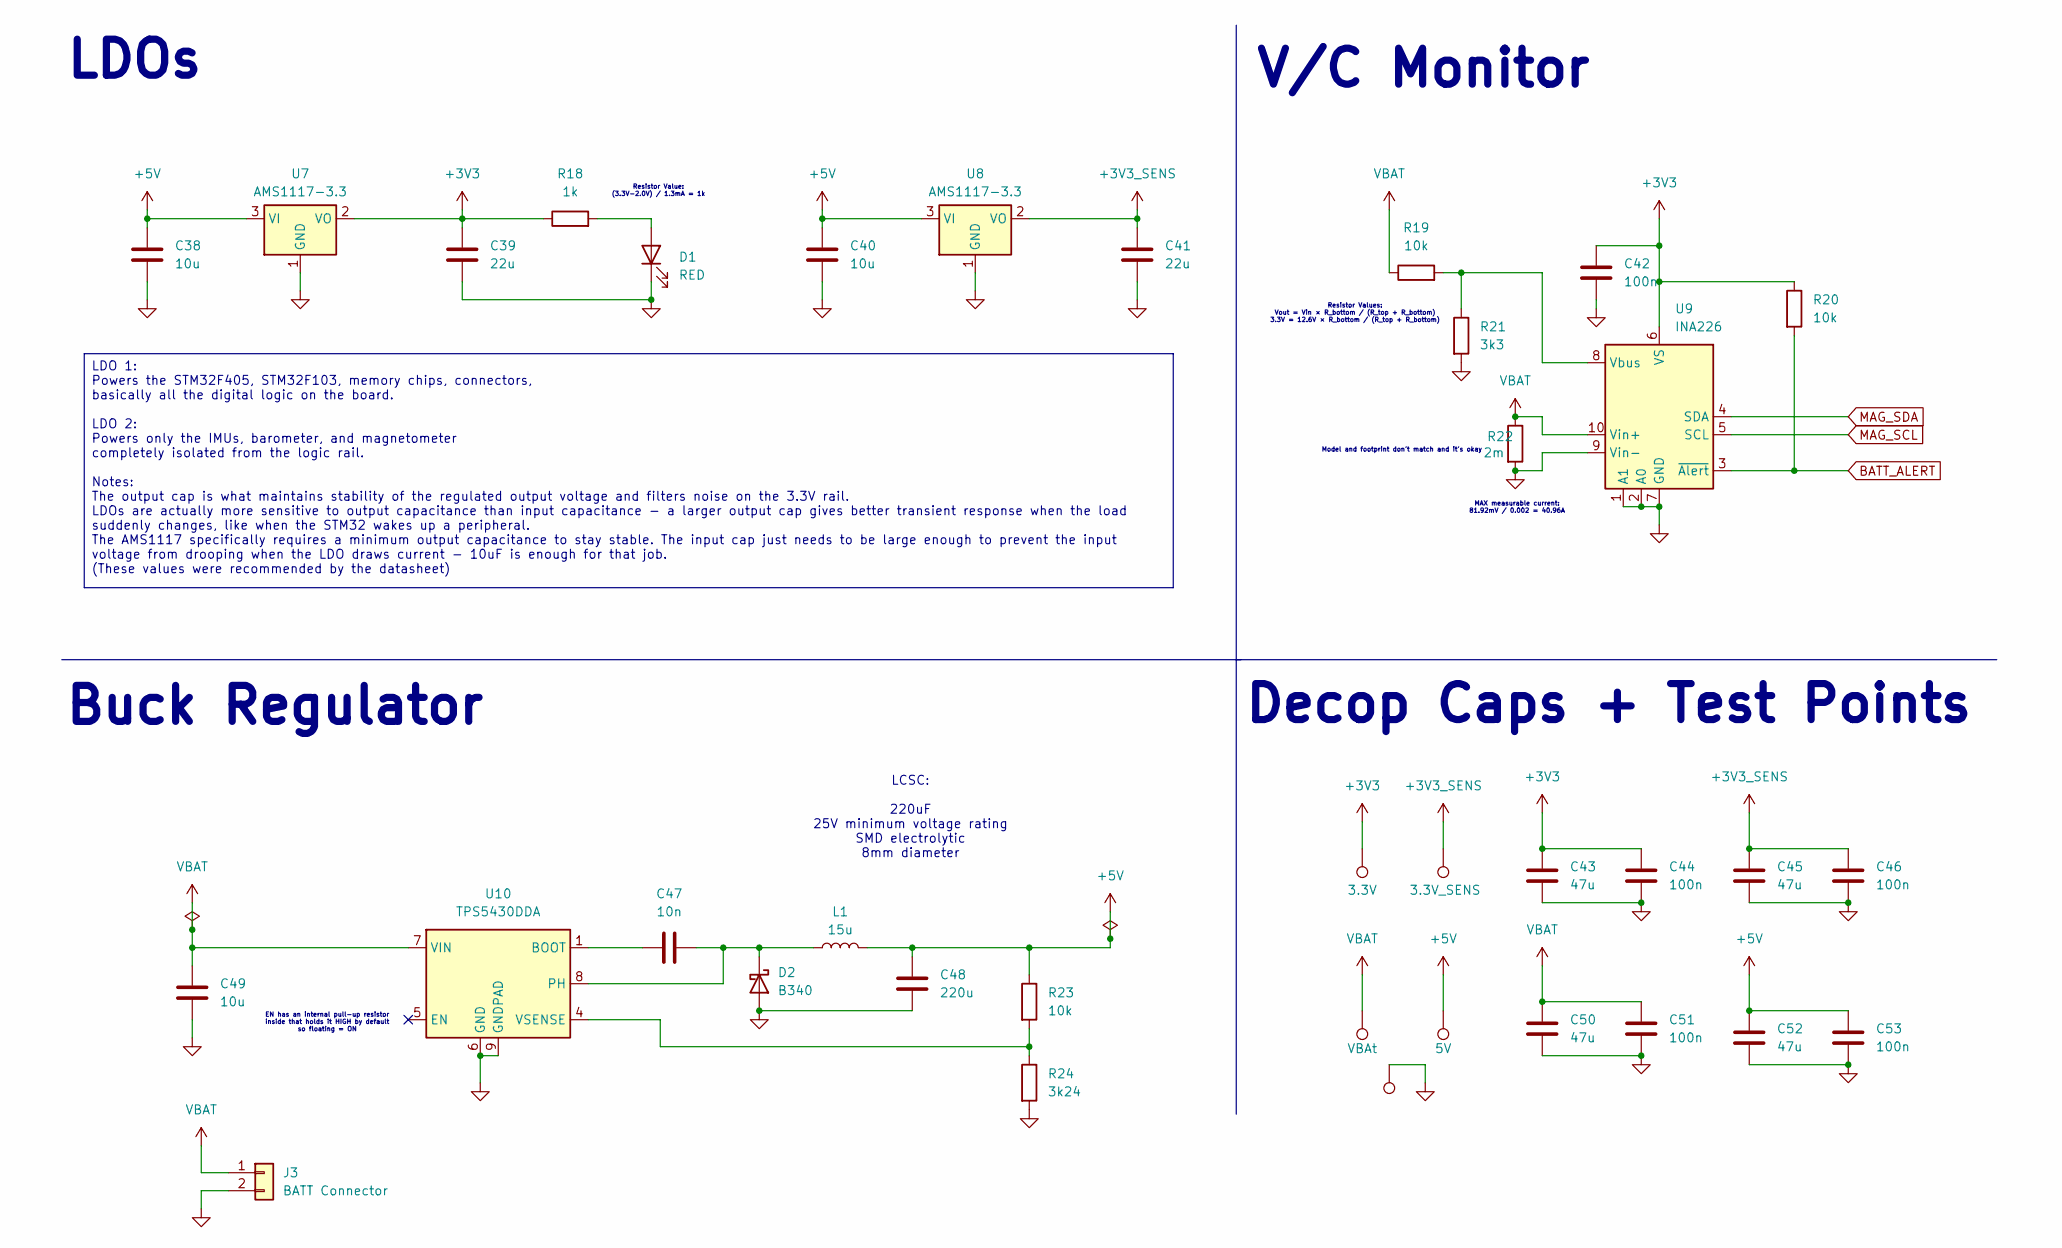
[picture p37: schematic PSM_FlightController_sch.kicad_sch]

Parts:
3.3V, 3.3V_SENS, 5V: TestPoint; TestPoint_Pad_1.0x1.0mm
C38, C40, C49: 10u; C_0603_1608Metric
C39, C41: 22u; C_0805_2012Metric
C42, C44, C46, C51, C53: 100n; C_0402_1005Metric
C43, C45, C50, C52: 47u; C_0805_2012Metric
C47: 10n; C_0402_1005Metric
C48: 220u; CP_Elec_8x10.5
D1: RED; LED_0805_2012Metric
D2: B340; D_SMA
J3: BATT Connector; AMASS_XT60PW-F_1x02_P7.20mm_Horizontal
L1: 15u; L_2512_6332Metric
R18: 1k; R_0402_1005Metric
R19, R20, R23: 10k; R_0402_1005Metric
R21: 3k3; R_0402_1005Metric
R22: 2m; R_Shunt_Vishay_WSK2512_6332Metric_T1.19mm
R24: 3k24; R_0402_1005Metric
TP5: TestPoint; TestPoint_Pad_1.0x1.0mm
U7, U8: AMS1117-3.3; SOT-223-3_TabPin2
U9: INA226; VSSOP-10_3x3mm_P0.5mm
U10: TPS5430DDA; TI_SO-PowerPAD-8_ThermalVias
VBAt: TestPoint; TestPoint_Pad_1.0x1.0mm

Connections:
+3V3: 3.3V.1, C39.1, C42.2, C43.2, C44.2, R18.1, R20.1, U7.2 (VO), U9.6 (VS); also elsewhere on the board
+3V3_SENS: 3.3V_SENS.1, C41.1, C45.2, C46.2, U8.2 (VO)
+5V: 5V.1, C38.1, C40.1, C48.2, C52.2, C53.2, L1.2, R23.1, U7.3 (VI), U8.3 (VI)
BATT_ALERT: R20.2, U9.3 (~Alert); also elsewhere on the board
GND: C38.2, C39.2, C40.2, C41.2, C42.1, C43.1, C44.1, C45.1, C46.1, C48.1, C49.2, C50.1, C51.1, C52.1, C53.1, D1.1 (K), D2.2 (A), J3.2, R21.2, R22.2, R24.2, TP5.1, U7.1 (GND), U8.1 (GND), U9.1 (A1), U9.2 (A0), U9.7 (GND), U9.9 (Vin-), U10.6 (GND), U10.9 (GNDPAD); also elsewhere on the board
MAG_SCL: U9.5 (SCL); also elsewhere on the board
MAG_SDA: U9.4 (SDA); also elsewhere on the board
unnamed: D1.2 (A), R18.2
unnamed: C47.2, D2.1 (K), L1.1, U10.8 (PH)
unnamed: R19.2, R21.1, U9.8 (Vbus)
unnamed: C47.1, U10.1 (BOOT)
unnamed: R23.2, R24.1, U10.4 (VSENSE)
VBAT: C49.1, C50.2, C51.2, J3.1, R19.1, R22.1, U9.10 (Vin+), U10.7 (VIN), VBAt.1; also elsewhere on the board

Notes on the sheet:
LCSC: 220uF 25V minimum voltage rating SMD electrolytic 8mm diameter
Buck Regulator
Resistor Values: Vout = Vin × R_bottom / (R_top + R_bottom) 3.3V = 12.6V × R_bottom / (R_top + R_bottom)
Model and footprint don't match and it's okay
Resistor Value: (3.3V-2.0V) / 1.3mA = 1k
V/C Monitor
EN has an internal pull-up resistor inside that holds it HIGH by default so floating = ON
MAX measurable current: 81.92mV / 0.002 = 40.96A
Decop Caps + Test Points
LDOs
LDO 1: Powers the STM32F405, STM32F103, memory chips, connectors, basically all the digital logic on the board. LDO 2: Powers only the IMUs, barometer, and magnetometer completely isolated from the logic rail. Notes: The output cap is what maintains stability of the regulated output voltage and fil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

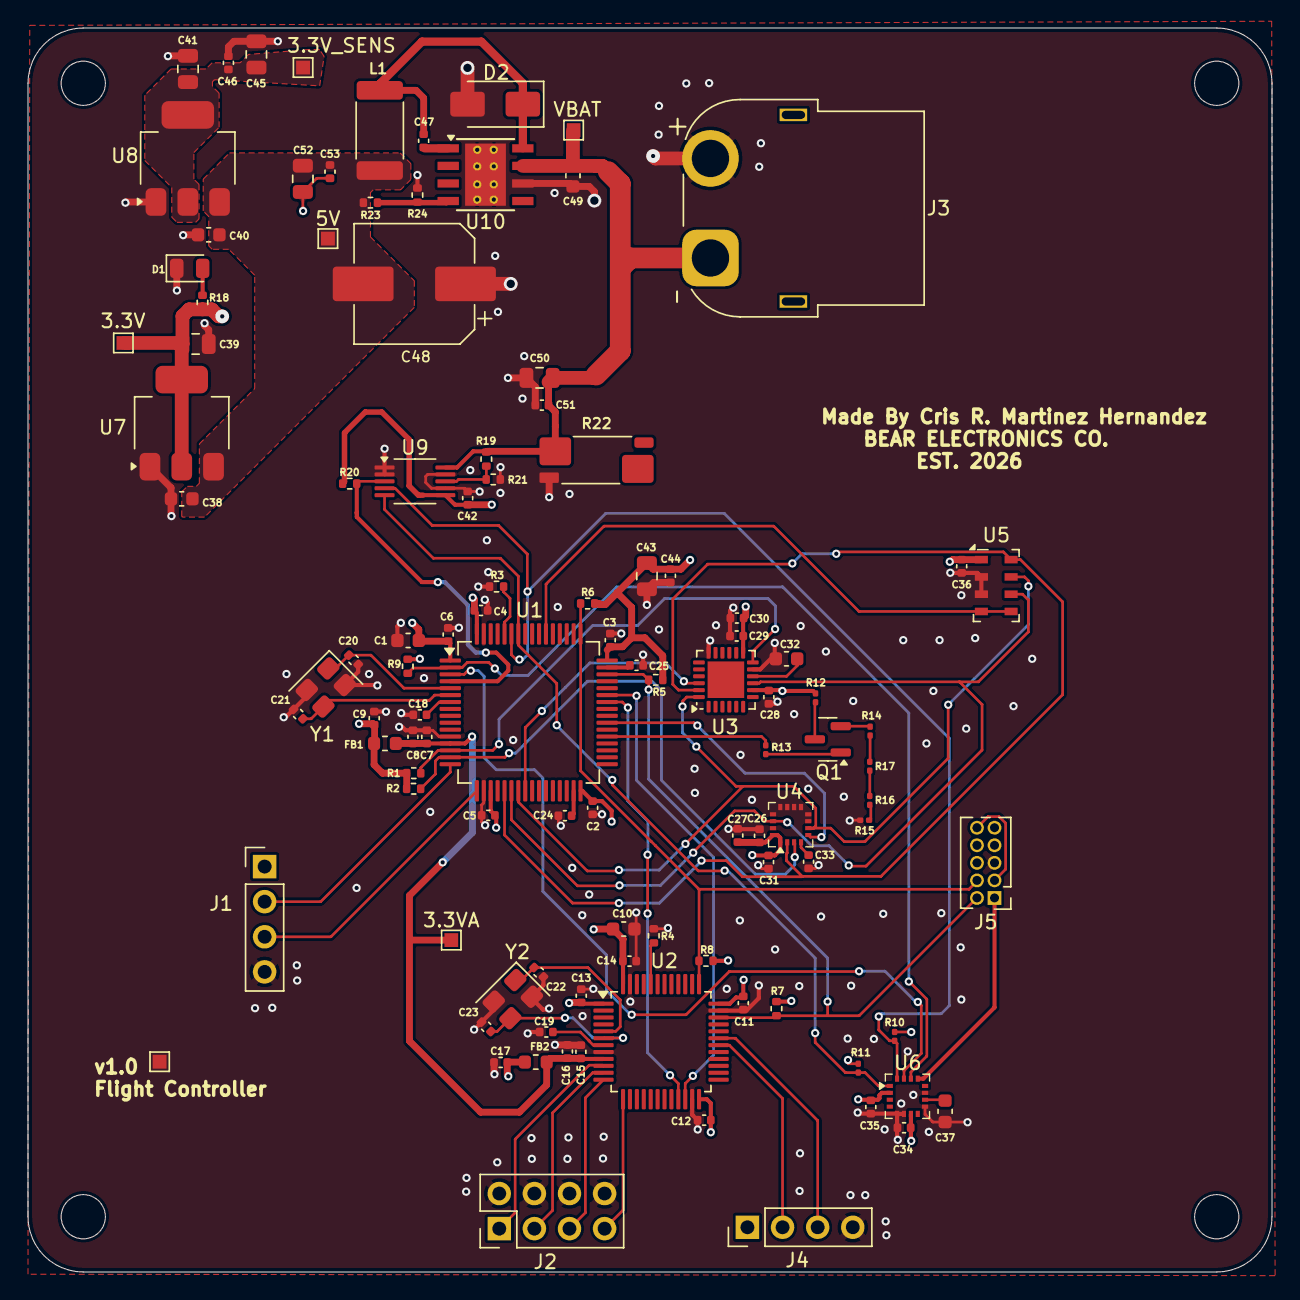
[picture p38: board FlightControllerv1.0.kicad_pcb from above]

Board: 4 copper layers, 90.0 x 90.0 mm, 110 parts (0 on the bottom side), 57 nets.

Other parts of the board:
3.3VA: TestPoint; TestPoint_Pad_1.0x1.0mm
VBAT: TestPoint; TestPoint_Pad_1.0x1.0mm

Their connections:
+3.3VA: 3.3VA.1; also elsewhere on the board
VBAT: VBAT.1; also elsewhere on the board
